SloBloLabs/MCUTestBoard/Enclosure/MCUTestBoardEnclosure.stl

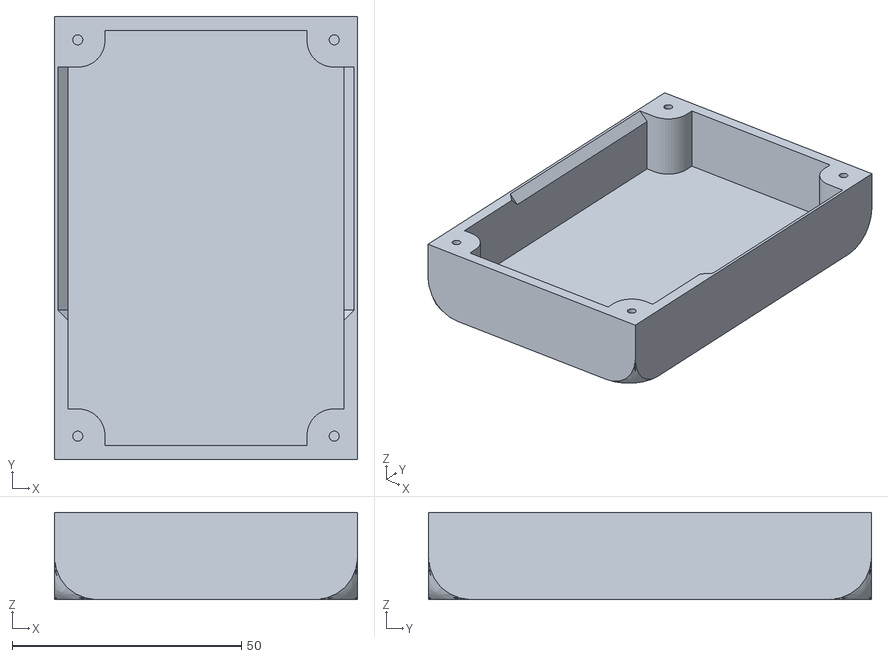
[picture p1: CAD file, 2025-04-04]
Enclosure/MCUTestBoardEnclosure.stl
66.0 x 96.5 x 19.0
