SloBloLabs/MCUTestBoard/(list of files, cad)

Other CAD files:
Enclosure/MCUTestBoardEnclosure.blend
