SloBloLabs/MCUTestBoard/MCUTestBoard.kicad_pcb

## KiCad design MCUTestBoard.kicad_pcb (2025-03-16)

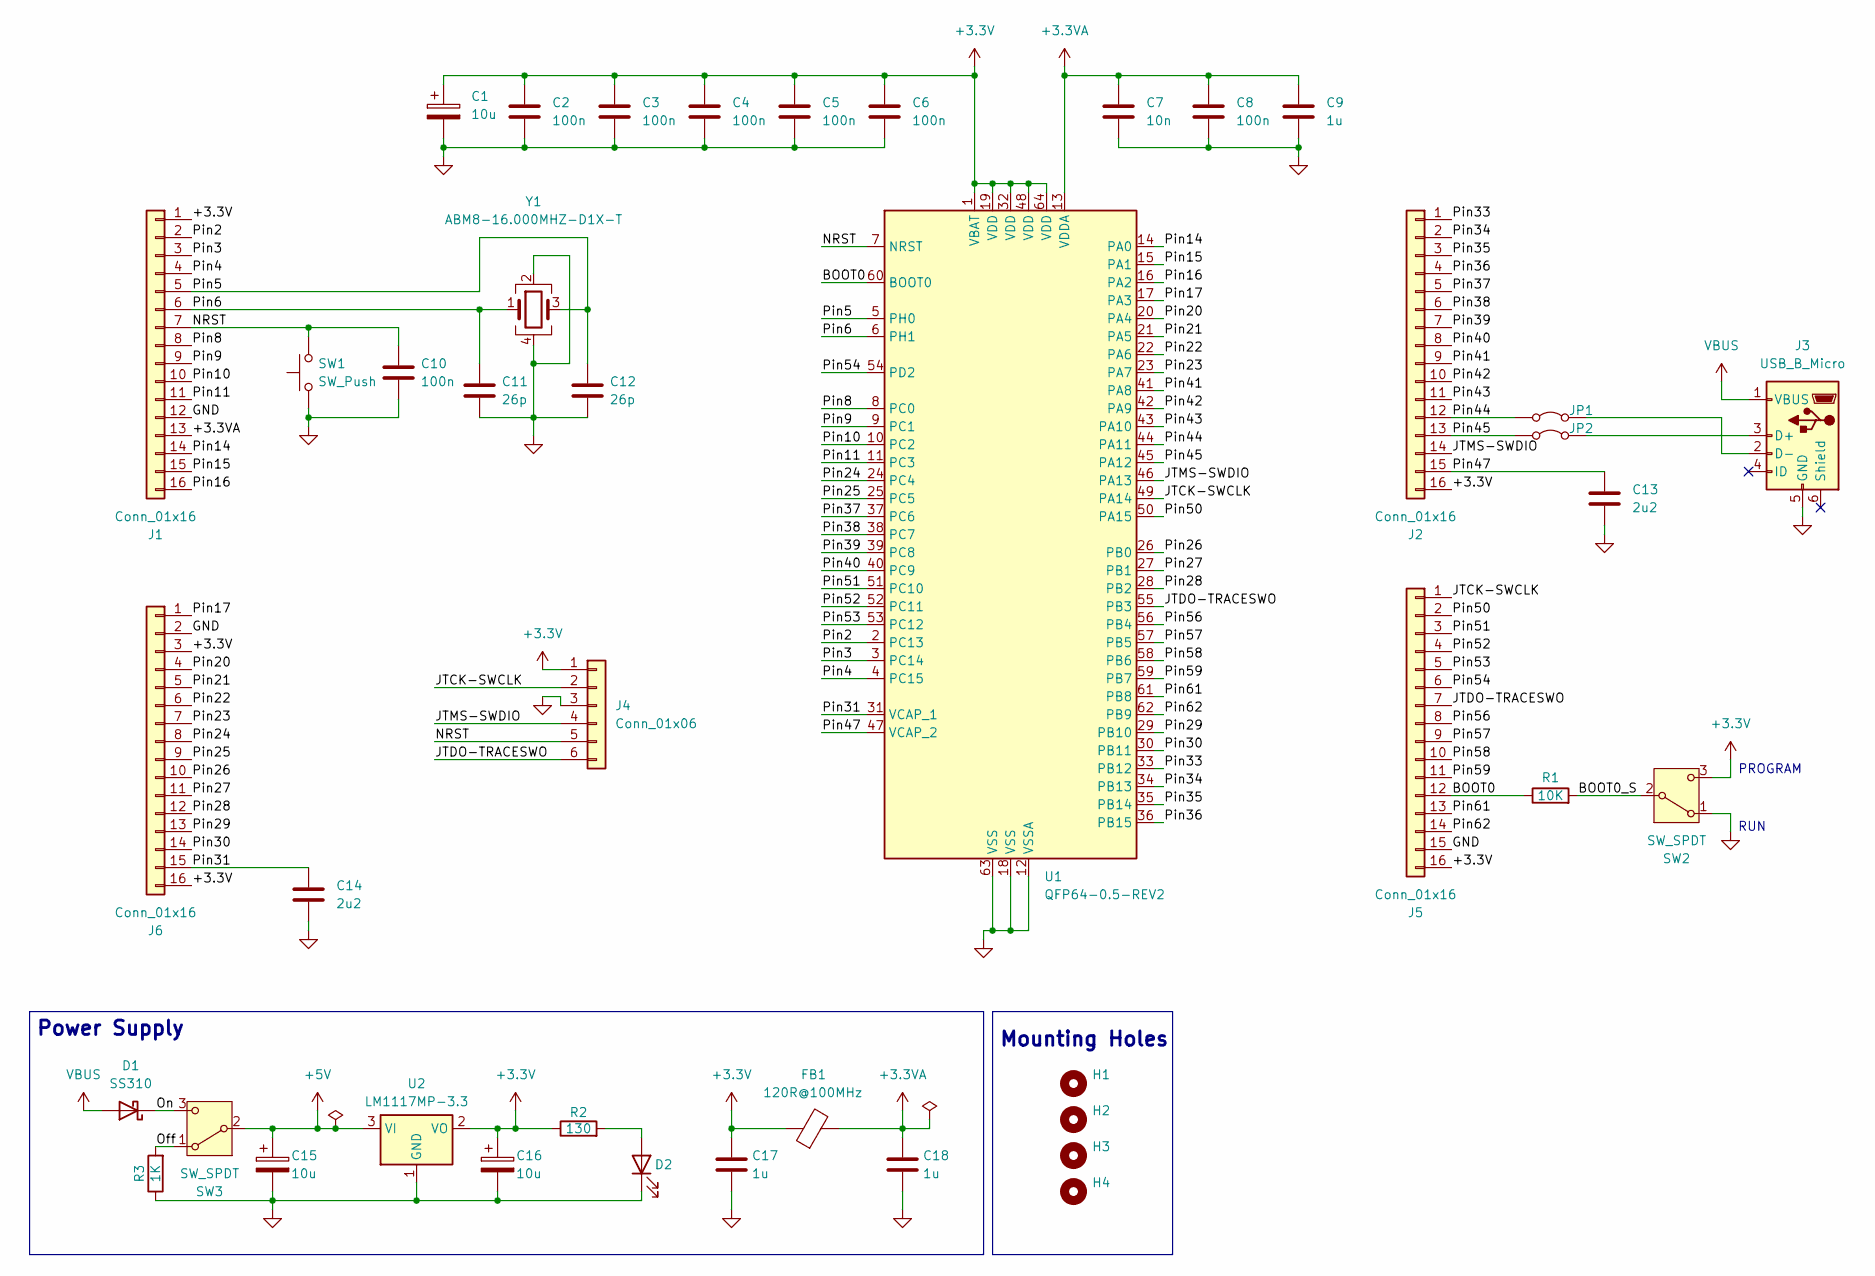
[picture p2: schematic MCUTestBoard.kicad_sch]

Parts:
C1, C15, C16: 10u; CP_Radial_D8.0mm_P3.50mm
C2, C3, C4, C5, C6, C8, C10: 100n; C_Rect_L7.2mm_W2.5mm_P5.00mm_FKS2_FKP2_MKS2_MKP2
C7: 10n; C_Rect_L7.2mm_W2.5mm_P5.00mm_FKS2_FKP2_MKS2_MKP2
C9, C17, C18: 1u; C_Rect_L7.2mm_W5.5mm_P5.00mm_FKS2_FKP2_MKS2_MKP2
C11, C12: 26p; C_0603_1608Metric_Pad1.08x0.95mm_HandSolder
C13, C14: 2u2; C_0603_1608Metric_Pad1.08x0.95mm_HandSolder
D1: SS310; D_SMA
D2: LED; LED_D5.0mm_Clear
FB1: 120R@100MHz; L_0603_1608Metric
H1, H2, H3, H4: MountingHole; MountingHole_2.7mm_M2.5
J1, J2, J5, J6: Conn_01x16; PinHeader_1x16_P2.54mm_Vertical
J3: USB_B_Micro; USB_Micro-B_Wuerth_629105150521
J4: Conn_01x06; PinHeader_1x06_P2.54mm_Vertical
JP1, JP2: Jumper_2_Bridged; PinHeader_1x02_P2.54mm_Vertical
R1: 10K; R_Axial_DIN0207_L6.3mm_D2.5mm_P7.62mm_Horizontal
R2: 130; R_Axial_DIN0207_L6.3mm_D2.5mm_P7.62mm_Horizontal
R3: 1K; R_Axial_DIN0207_L6.3mm_D2.5mm_P7.62mm_Horizontal
SW1: SW_Push; E-Switch_TL1105SP
SW2, SW3: SW_SPDT; SW_Toggle_MS500
U1: QFP64-0.5-REV2
U2: LM1117MP-3.3; SOT-223-3_TabPin2
Y1: ABM8-16.000MHZ-D1X-T; Crystal_SMD_3225-4Pin_3.2x2.5mm_HandSoldering

Connections:
+3.3V: C1.1, C2.1, C3.1, C4.1, C5.1, C6.1, C16.1, C17.1, FB1.1, J1.1, J2.16, J4.1, J5.16, J6.3, J6.16, R2.1, SW2.3 (C), U1.1 (VBAT), U1.19 (VDD), U1.32 (VDD), U1.48 (VDD), U1.64 (VDD), U2.2 (VO)
+3.3VA: C7.1, C8.1, C9.1, C18.1, FB1.2, J1.13, U1.13 (VDDA)
+5V: C15.1, SW3.2 (B), U2.3 (VI)
/BOOT0: J5.12, R1.1, U1.60 (BOOT0)
/BOOT0_S: R1.2, SW2.2 (B)
/JTCK-SWCLK: J4.2, J5.1, U1.49 (PA14)
/JTDO-TRACESWO: J4.6, J5.7, U1.55 (PB3)
/JTMS-SWDIO: J2.14, J4.4, U1.46 (PA13)
/NRST: C10.1, J1.7, J4.5, SW1.2, U1.7 (NRST)
/Off: R3.2, SW3.1 (A)
/On: D1.1 (K), SW3.3 (C)
/Pin2: J1.2, U1.2 (PC13)
/Pin3: J1.3, U1.3 (PC14)
/Pin4: J1.4, U1.4 (PC15)
/Pin5: C12.1, J1.5, U1.5 (PH0), Y1.3
/Pin6: C11.1, J1.6, U1.6 (PH1), Y1.1
/Pin8: J1.8, U1.8 (PC0)
/Pin9: J1.9, U1.9 (PC1)
/Pin10: J1.10, U1.10 (PC2)
/Pin11: J1.11, U1.11 (PC3)
/Pin14: J1.14, U1.14 (PA0)
/Pin15: J1.15, U1.15 (PA1)
/Pin16: J1.16, U1.16 (PA2)
/Pin17: J6.1, U1.17 (PA3)
/Pin20: J6.4, U1.20 (PA4)
/Pin21: J6.5, U1.21 (PA5)
/Pin22: J6.6, U1.22 (PA6)
/Pin23: J6.7, U1.23 (PA7)
/Pin24: J6.8, U1.24 (PC4)
/Pin25: J6.9, U1.25 (PC5)
/Pin26: J6.10, U1.26 (PB0)
/Pin27: J6.11, U1.27 (PB1)
/Pin28: J6.12, U1.28 (PB2)
/Pin29: J6.13, U1.29 (PB10)
/Pin30: J6.14, U1.30 (PB11)
/Pin31: C14.1, J6.15, U1.31 (VCAP_1)
/Pin33: J2.1, U1.33 (PB12)
/Pin34: J2.2, U1.34 (PB13)
/Pin35: J2.3, U1.35 (PB14)
/Pin36: J2.4, U1.36 (PB15)
/Pin37: J2.5, U1.37 (PC6)
/Pin38: J2.6, U1.38 (PC7)
/Pin39: J2.7, U1.39 (PC8)
/Pin40: J2.8, U1.40 (PC9)
/Pin41: J2.9, U1.41 (PA8)
/Pin42: J2.10, U1.42 (PA9)
/Pin43: J2.11, U1.43 (PA10)
/Pin44: J2.12, JP1.1 (A), U1.44 (PA11)
/Pin45: J2.13, JP2.1 (A), U1.45 (PA12)
/Pin47: C13.1, J2.15, U1.47 (VCAP_2)
/Pin50: J5.2, U1.50 (PA15)
/Pin51: J5.3, U1.51 (PC10)
/Pin52: J5.4, U1.52 (PC11)
/Pin53: J5.5, U1.53 (PC12)
/Pin54: J5.6, U1.54 (PD2)
/Pin56: J5.8, U1.56 (PB4)
/Pin57: J5.9, U1.57 (PB5)
/Pin58: J5.10, U1.58 (PB6)
/Pin59: J5.11, U1.59 (PB7)
/Pin61: J5.13, U1.61 (PB8)
/Pin62: J5.14, U1.62 (PB9)
GND: C1.2, C2.2, C3.2, C4.2, C5.2, C6.2, C7.2, C8.2, C9.2, C10.2, C11.2, C12.2, C13.2, C14.2, C15.2, C16.2, C17.2, C18.2, D2.1 (K), J1.12, J3.5 (GND), J4.3, J5.15, J6.2, R3.1, SW1.1, SW2.1 (A), U1.12 (VSSA), U1.18 (VSS), U1.63 (VSS), U2.1 (GND), Y1.2, Y1.4
unnamed: D2.2 (A), R2.2
unnamed: J3.3 (D+), JP2.2 (B)
unnamed: J3.2 (D-), JP1.2 (B)
VBUS: D1.2 (A), J3.1 (VBUS)

Notes on the sheet:
RUN
PROGRAM
Mounting Holes
Power Supply

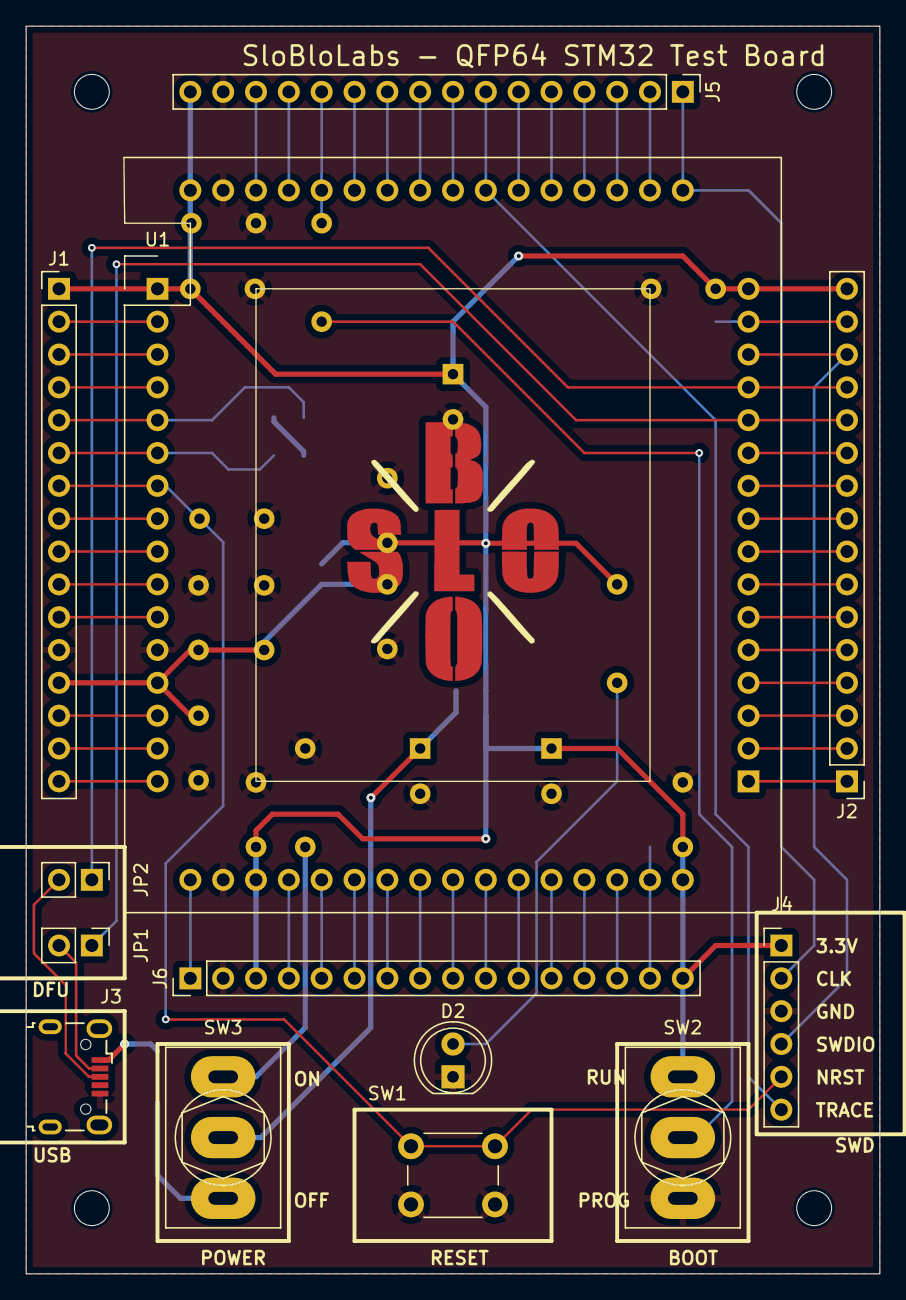
[picture p3: board MCUTestBoard.kicad_pcb from above]

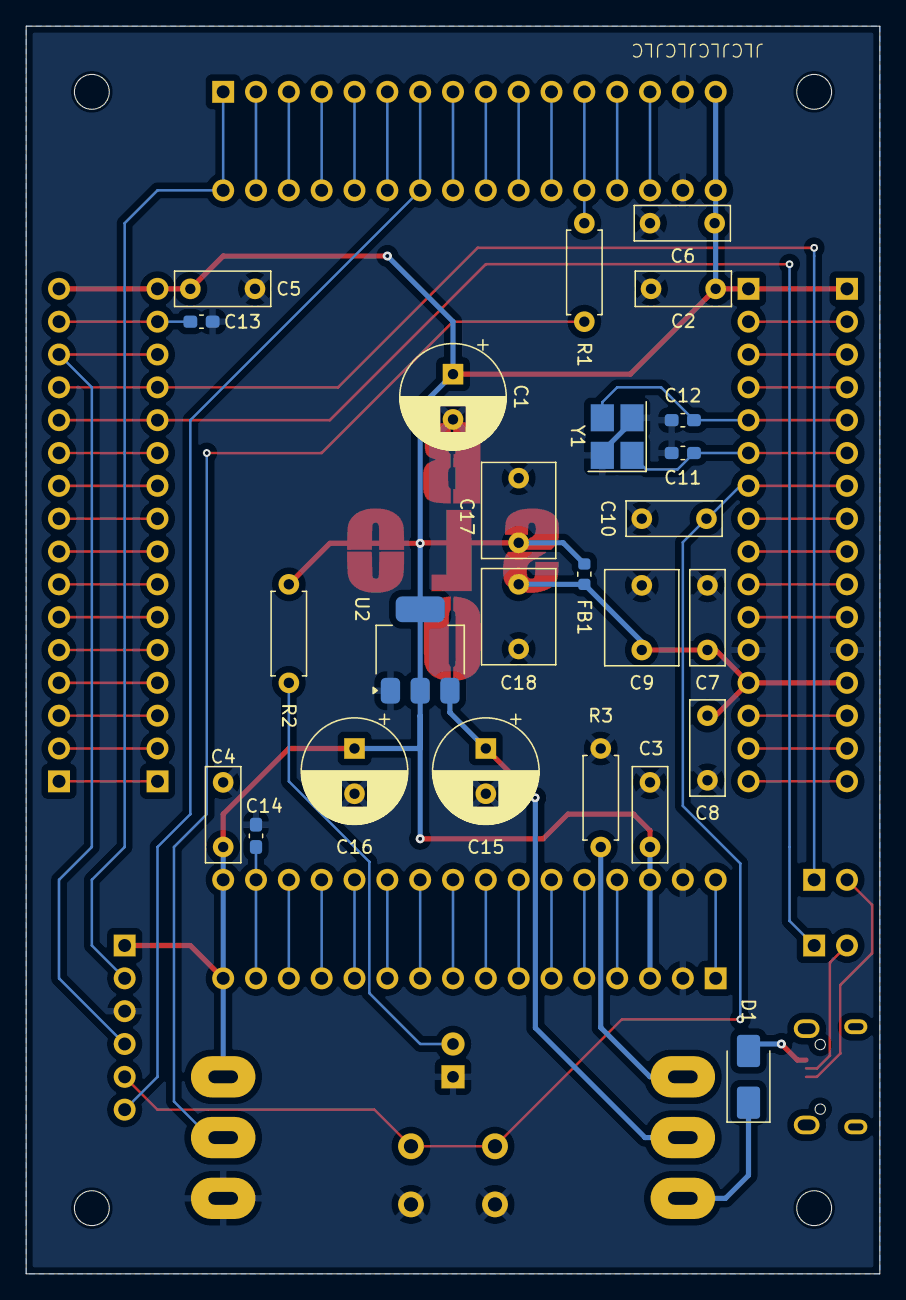
[picture p4: board MCUTestBoard.kicad_pcb from below]

Board: 2 copper layers, 66.0 x 96.5 mm, 43 parts (25 on the bottom side), 66 nets.

Other parts of the board:
Ref**: Val**; SloBloLogo_16x20
