SloBloLabs/MCUTestBoard/(commit log)

2025-03-16 Production version 1v00
    [MCUTestBoard.kicad_pcb, MCUTestBoard.kicad_sch, bom.csv, designators.csv, positions.csv]
2025-04-03 LED resistor 150R Add enclosure model add iBom
    [MCUTestBoard.kicad_sch, MCUTestBoardEnclosure.blend, MCUTestBoardEnclosure.stl]
2025-04-04 Trim width and hight Bevel @ pin connector
    [MCUTestBoardEnclosure.blend, MCUTestBoardEnclosure.stl]
